meznokto/pcbs/custom_esp32/3d.png

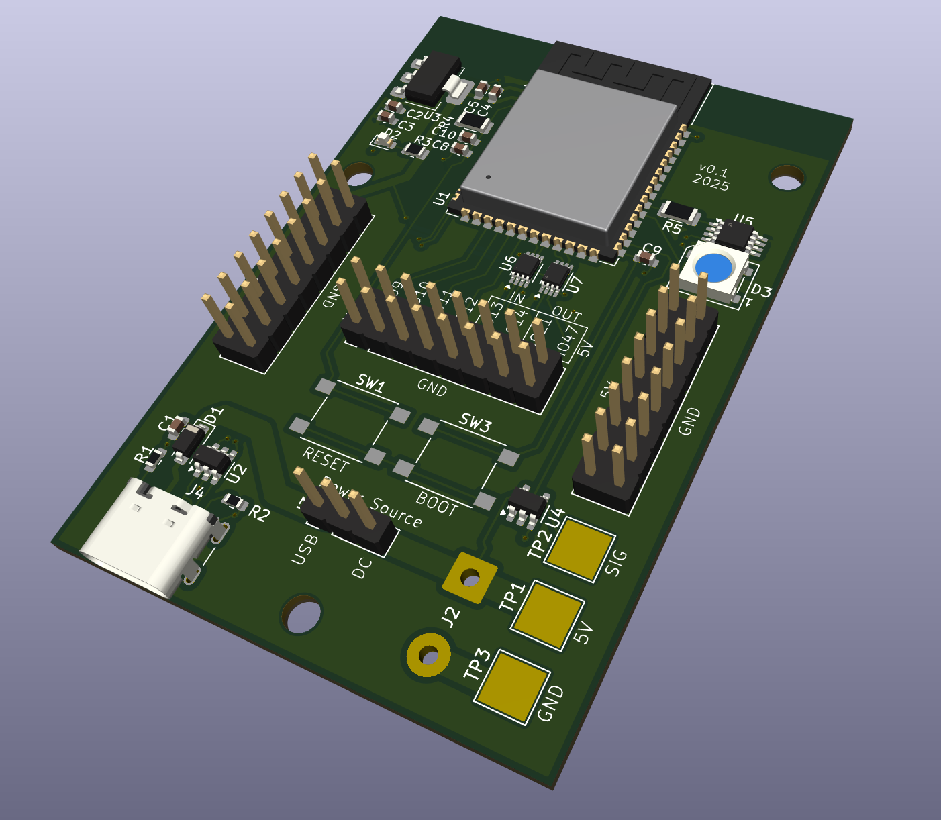
custom_esp32/3d.png
