meznokto/pcbs/custom_esp32/real.jpg

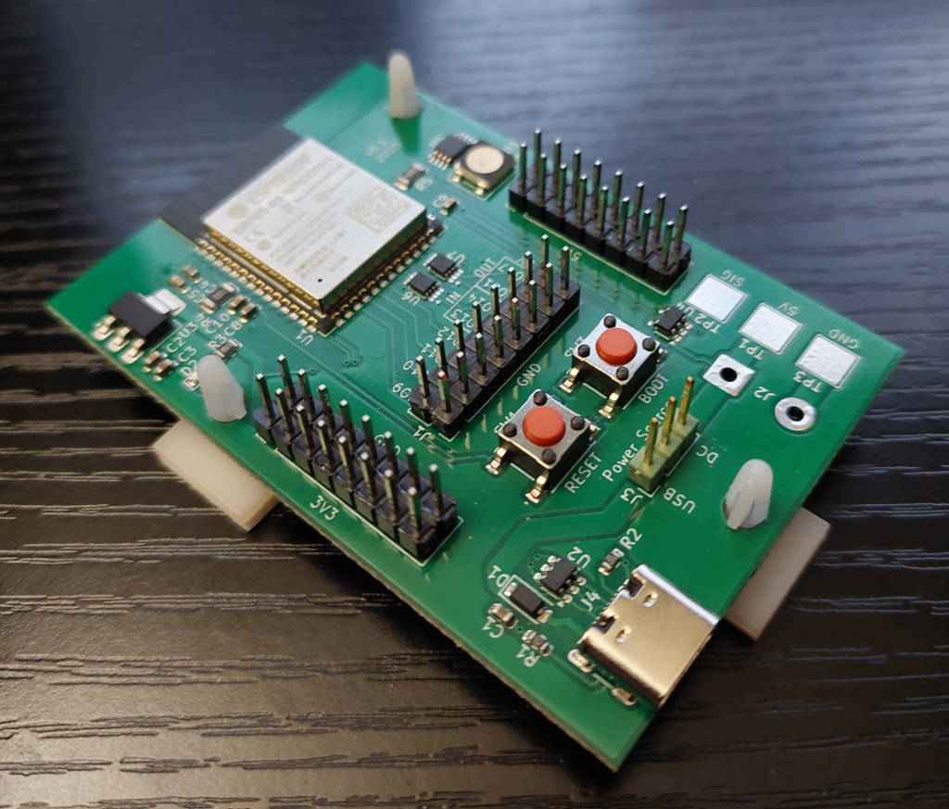
custom_esp32/real.jpg
