meznokto/pcbs/custom_esp32/pcb.png

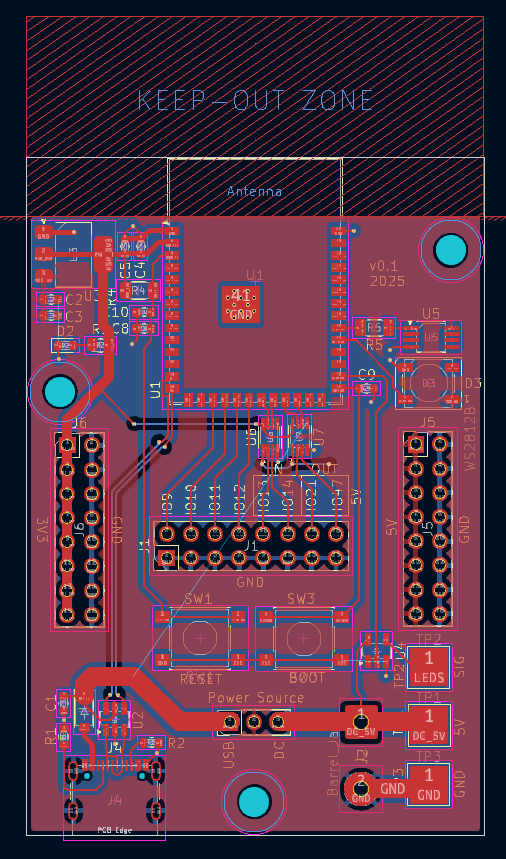
custom_esp32/pcb.png
