meznokto/pcbs/custom_esp32/custom_esp32.kicad_pcb

## KiCad design custom_esp32/custom_esp32.kicad_pcb (2025-12-06)

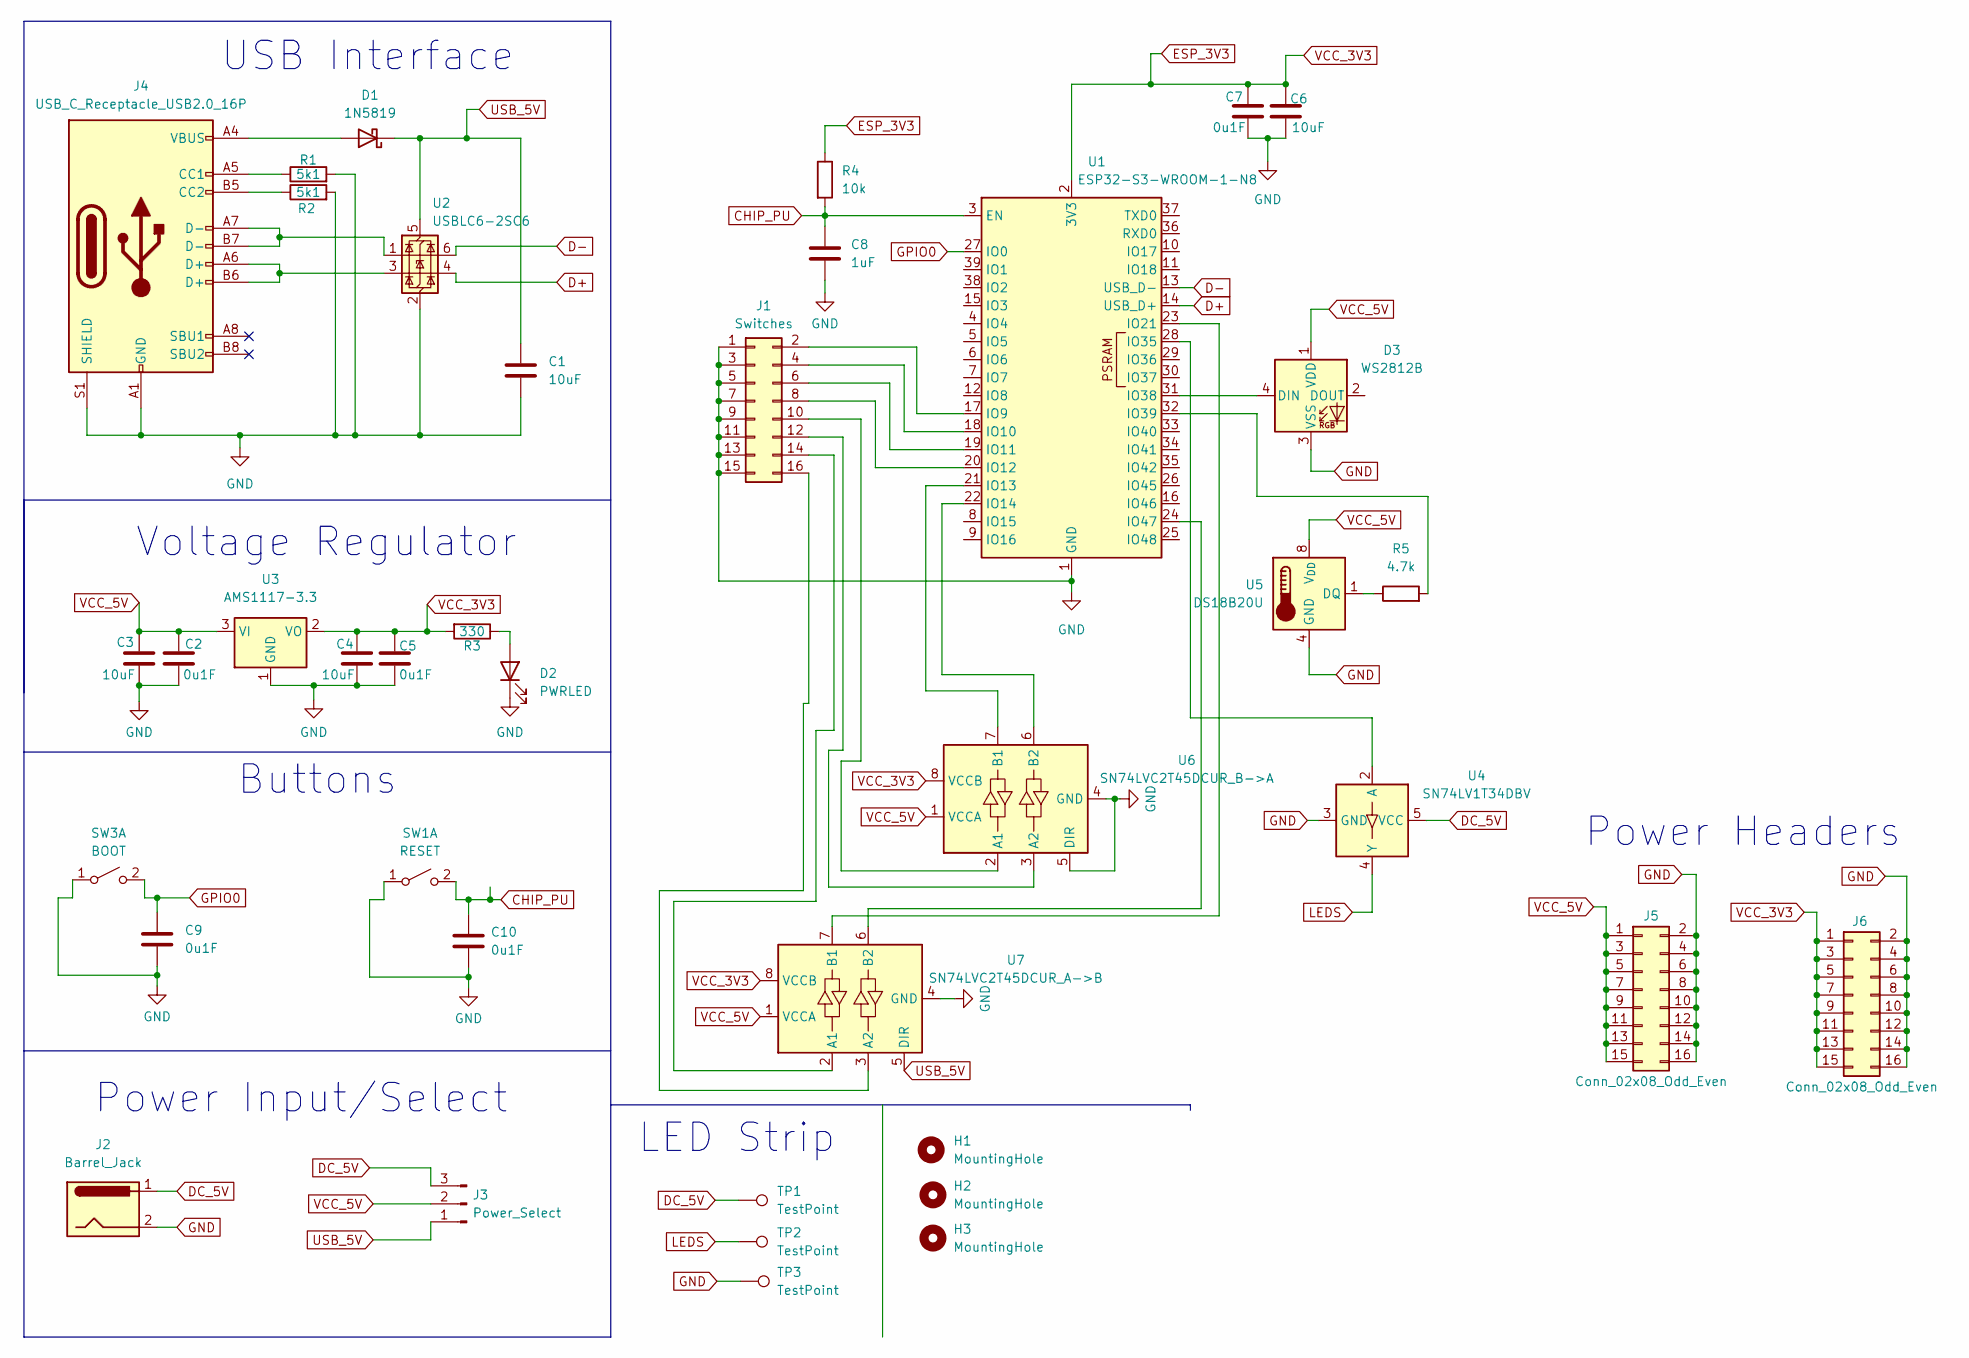
[picture p4: schematic custom_esp32.kicad_sch]

Parts:
C1, C3, C4: 10uF; C_0603_1608Metric; LCSC C19702
C2, C5, C9, C10: 0u1F; C_0603_1608Metric; LCSC C14663
C6: 10uF; LCSC C23186
C7: 0u1F; LCSC C1525
C8: 1uF; C_0603_1608Metric; LCSC C1592
D1: 1N5819; D_SOD-123; LCSC C82544
D2: PWRLED; LED_0603_1608Metric; LCSC C2286
D3: WS2812B; LED_WS2812B_PLCC4_5.0x5.0mm_P3.2mm; LCSC C2761795
H1, H2, H3: MountingHole; MountingHole_3.2mm_M3
J1: Switches; PinHeader_2x08_P2.54mm_Vertical; LCSC C61915
J2: Barrel_Jack; SolderWire-0.75sqmm_1x02_P7mm_D1.25mm_OD3.5mm
J3: Power_Select; PinHeader_1x03_P2.54mm_Vertical; LCSC C306127
J4: USB_C_Receptacle_USB2.0_16P; USB_C_Receptacle_GCT_USB4105-xx-A_16P_TopMnt_Horizontal; LCSC C2765186
J5, J6: Conn_02x08_Odd_Even; PinHeader_2x08_P2.54mm_Vertical
R1, R2: 5k1; R_0603_1608Metric; LCSC C23186
R3: 330; R_0805_2012Metric; LCSC C17630
R4: 10k; R_1206_3216Metric; LCSC C1489
R5: 4.7k; R_1206_3216Metric; LCSC C17936
SW1: RESET; SW_SPST_PTS645; LCSC C221871
SW3: BOOT; SW_SPST_PTS645; LCSC C221871
TP1, TP2, TP3: TestPoint; TestPoint_Pad_4.0x4.0mm
U1: ESP32-S3-WROOM-1-N8; ESP32-S3-WROOM-1; LCSC C2913198
U2: USBLC6-2SC6; SOT-23-6; LCSC C7519
U3: AMS1117-3.3; SOT-223-3_TabPin2; LCSC C6186
U4: SN74LV1T34DBV; SOT-23-5; LCSC C100024
U5: DS18B20U; MSOP-8_3x3mm_P0.65mm; LCSC C695836
U6: SN74LVC2T45DCUR_B->A; VSSOP-8_2.3x2mm_P0.5mm; LCSC C15741
U7: SN74LVC2T45DCUR_A->B; VSSOP-8_2.3x2mm_P0.5mm; LCSC C15741

Connections:
CHIP_PU: C8.1, C10.1, R4.2, SW1.2 (B), U1.3 (EN)
D+: U1.14 (USB_D+), U2.4 (I/O2)
D-: U1.13 (USB_D-), U2.6 (I/O1)
DC_5V: J2.1, J3.3, TP1.1, U4.5 (VCC)
ESP_3V3: C4.1, C5.1, C6.1, C7.1, J6.1, J6.3, J6.5, J6.7, J6.9, J6.11, J6.13, J6.15, R3.2, R4.1, U1.2 (3V3), U3.2 (VO), U6.8 (VCCB), U7.8 (VCCB)
GND: C1.2, C2.2, C3.2, C4.2, C5.2, C6.2, C7.2, C8.2, C9.2, C10.2, D2.1 (K), D3.3 (VSS), J1.1, J1.3, J1.5, J1.7, J1.9, J1.11, J1.13, J1.15, J2.2, J4.A1 (GND), J4.A12 (GND), J4.B1 (GND), J4.B12 (GND), J4.S1 (SHIELD), J5.2, J5.4, J5.6, J5.8, J5.10, J5.12, J5.14, J5.16, J6.2, J6.4, J6.6, J6.8, J6.10, J6.12, J6.14, J6.16, R1.2, R2.2, SW1.1 (A), SW3.1 (A), TP3.1, U1.1 (GND), U1.40 (GND), U1.41 (GND), U2.2 (GND), U3.1 (GND), U4.3 (GND), U5.4 (GND), U6.4 (GND), U6.5 (DIR), U7.4 (GND)
GPIO0: C9.1, SW3.2 (B), U1.27 (IO0)
LEDS: TP2.1, U4.4 (Y)
unnamed: D1.2 (A), J4.A4 (VBUS), J4.A9 (VBUS), J4.B4 (VBUS), J4.B9 (VBUS)
unnamed: D2.2 (A), R3.1
unnamed: D3.4 (DIN), U1.31 (IO38)
unnamed: J1.2, U1.17 (IO9)
unnamed: J1.4, U1.18 (IO10)
unnamed: J1.6, U1.19 (IO11)
unnamed: J1.8, U1.20 (IO12)
unnamed: J1.10, U6.2 (A1)
unnamed: J1.12, U6.3 (A2)
unnamed: J1.14, U7.2 (A1)
unnamed: J1.16, U7.3 (A2)
unnamed: J4.A5 (CC1), R1.1
unnamed: J4.B5 (CC2), R2.1
unnamed: J4.A6 (D+), J4.B6 (D+), U2.3 (I/O2)
unnamed: J4.A7 (D-), J4.B7 (D-), U2.1 (I/O1)
unnamed: U1.21 (IO13), U6.7 (B1)
unnamed: U1.22 (IO14), U6.6 (B2)
unnamed: U1.23 (IO21), U7.7 (B1)
unnamed: U1.28 (IO35), U4.2 (A)
unnamed: R5.2, U1.32 (IO39)
unnamed: U1.24 (IO47), U7.6 (B2)
unnamed: R5.1, U5.1 (DQ)
USB_5V: C1.1, D1.1 (K), J3.1, U2.5 (VBUS), U7.5 (DIR)
VCC_5V: C2.1, C3.1, D3.1 (VDD), J3.2, J5.1, J5.3, J5.5, J5.7, J5.9, J5.11, J5.13, J5.15, U3.3 (VI), U5.8 (V_{DD}), U6.1 (VCCA), U7.1 (VCCA)

Notes on the sheet:
Power Headers
Power Input/Select
USB Interface
Buttons
Voltage Regulator
LED Strip

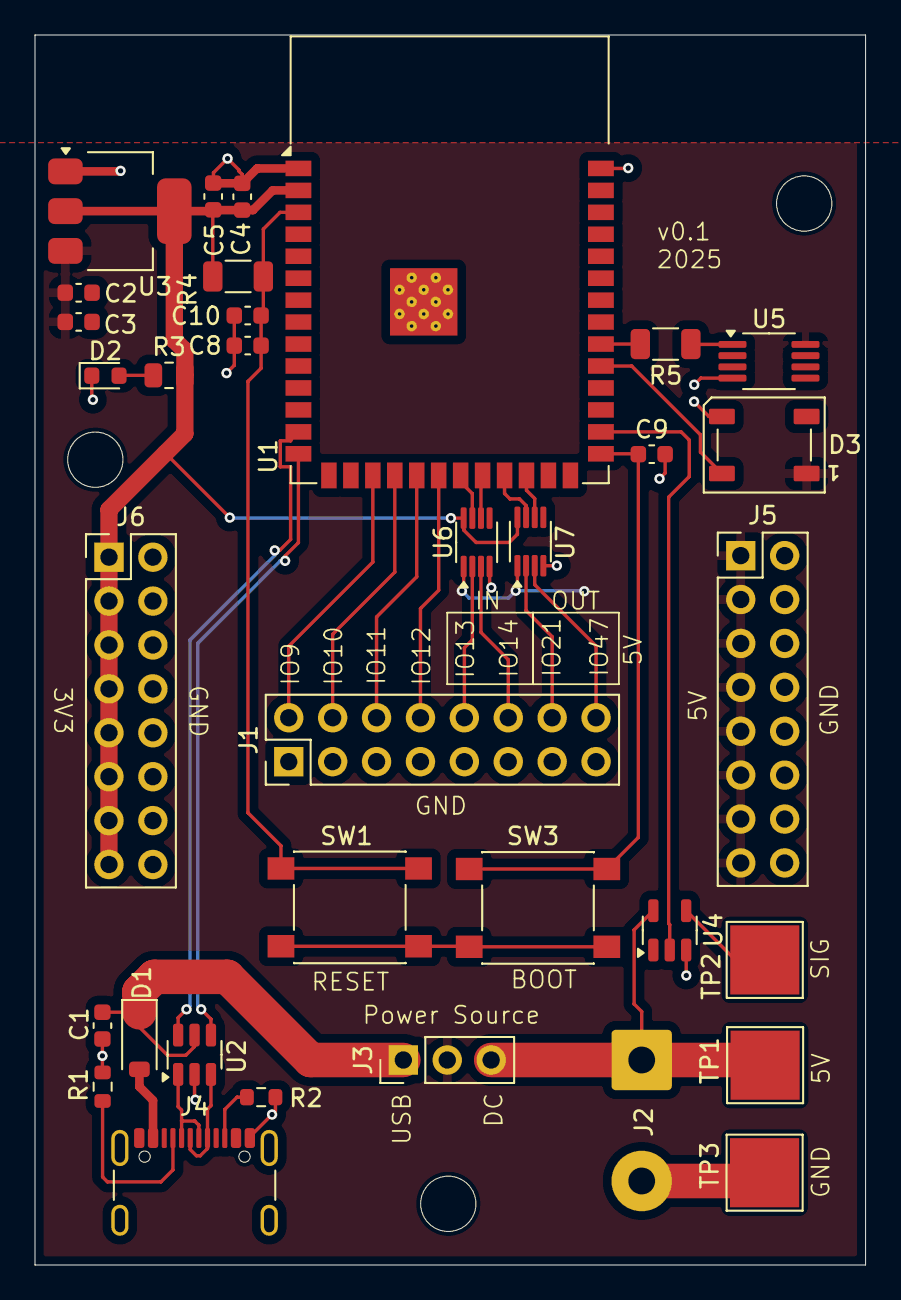
[picture p5: board custom_esp32.kicad_pcb from above]

Board: 2 copper layers, 48.0 x 71.2 mm, 37 parts (0 on the bottom side), 32 nets.
