meznokto/pcbs/(commit log)

2025-12-06 Initial commit.
    [custom_esp32.kicad_pcb, custom_esp32.kicad_sch]
2025-12-06 Added esp dev/led board.
    [custom_esp32.kicad_pcb, custom_esp32.kicad_sch]
2025-12-06 Added images for custom_esp32 pcb.
2025-12-19 Added picture of finished board.
